vanyap1/SAMD20_EincSmartMonitor/images/pic2.png

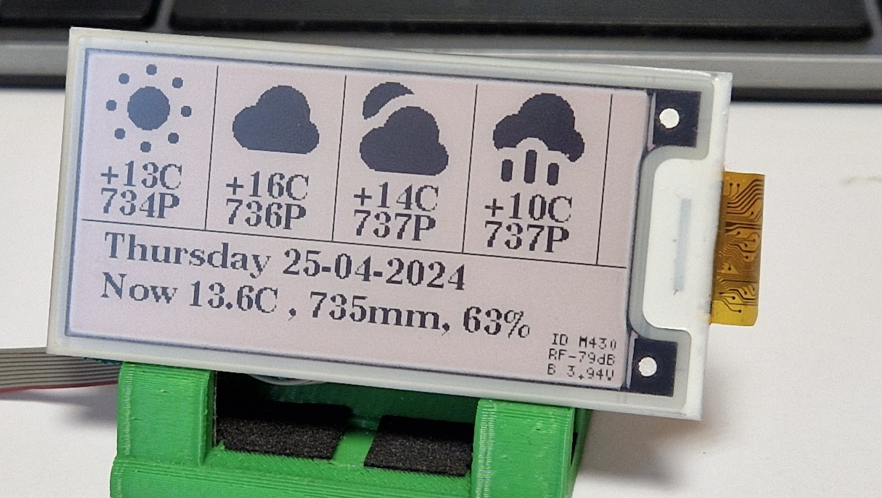
images/pic2.png
