vanyap1/SAMD20_EincSmartMonitor/images/pic1.png

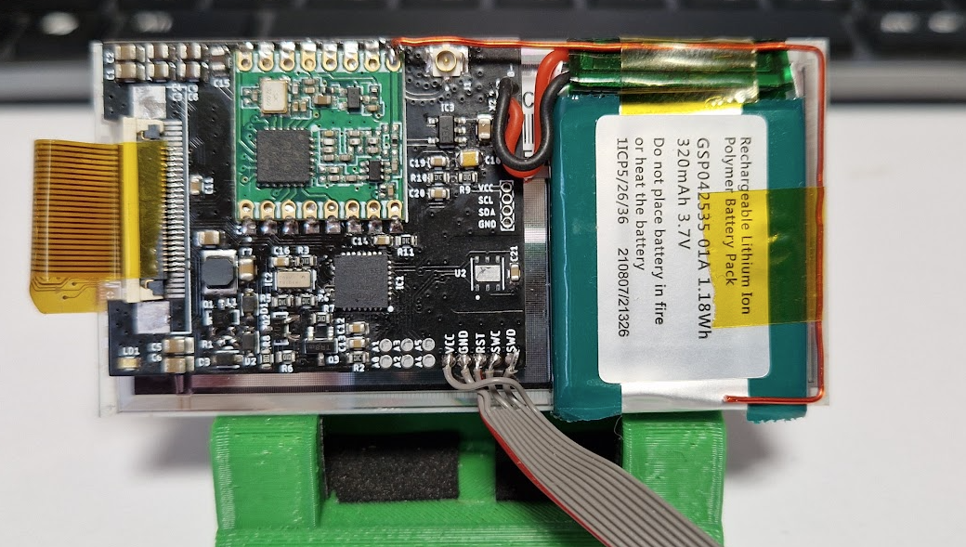
images/pic1.png
