vanyap1/SAMD20_EincSmartMonitor/README.md

# SAMD20_EinkSmartMonitor
Atmel SAMD20E17 mcu based EINK smart monitor with LORA module
