vanyap1/SAMD20_EincSmartMonitor/docu/u8g2_font_streamline_all_t.png

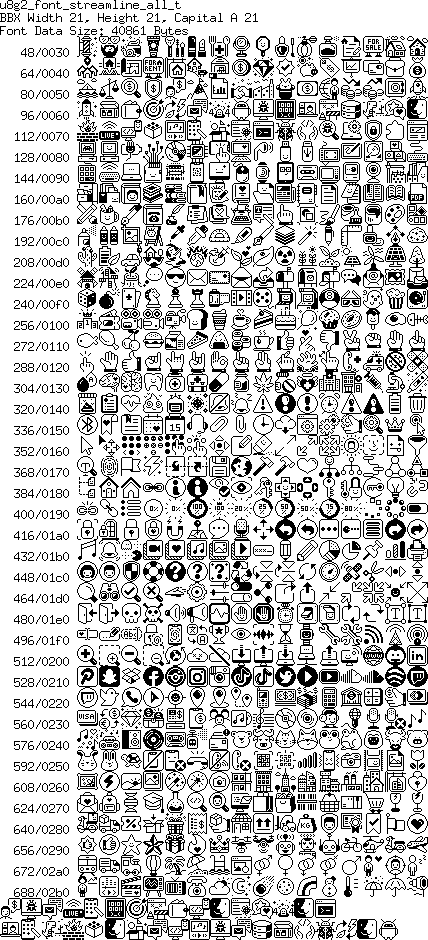
docu/u8g2_font_streamline_all_t.png
