vanyap1/SAMD20_EincSmartMonitor/images/pic3.png

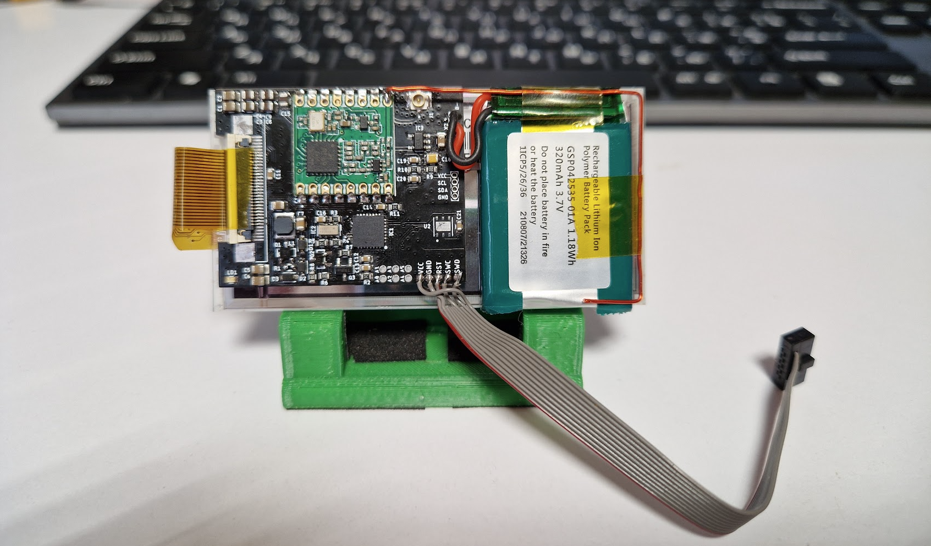
images/pic3.png
