vanyap1/SAMD20_EincSmartMonitor/images/pic4.png

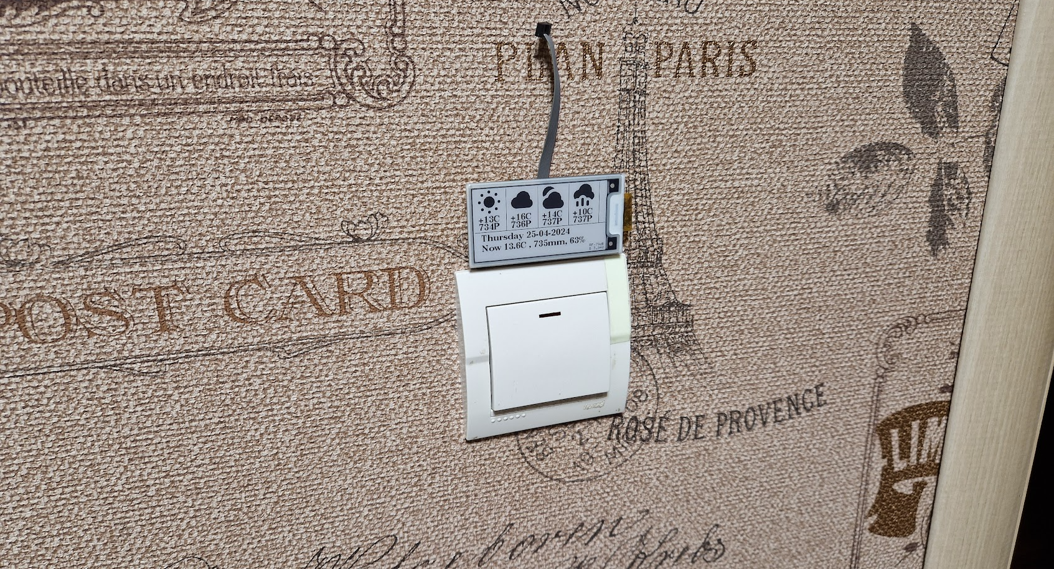
images/pic4.png
