vanyap1/SAMD20_EincSmartMonitor/3dParts/FrontCover_154.SLDPRT

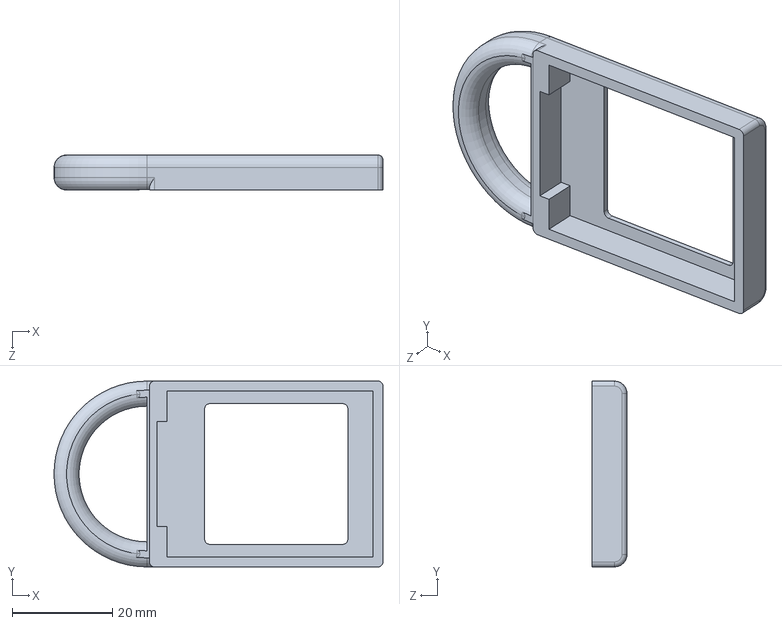
[picture p6: CAD file, 2024-04-30]
3dParts/FrontCover_154.SLDPRT
65.5 x 37.0 x 7.00 mm
