vanyap1/SAMD20_EincSmartMonitor/3dParts/FrontCover.SLDPRT

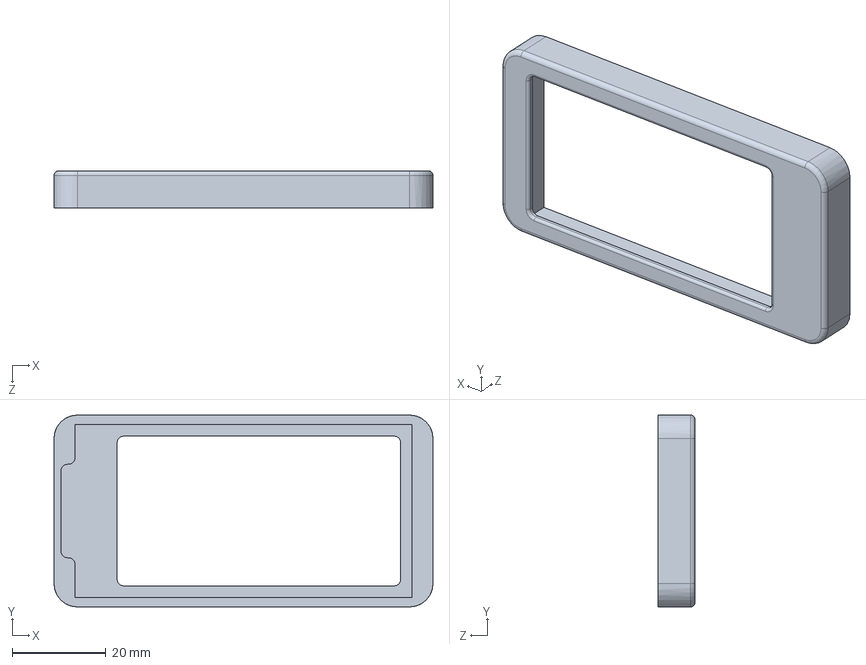
[picture p7: CAD file, 2024-04-27]
3dParts/FrontCover.SLDPRT
81.0 x 41.0 x 8.00 mm
