vanyap1/SAMD20_EincSmartMonitor/docu/eagle project/E-InkSmartMonitor.pdf

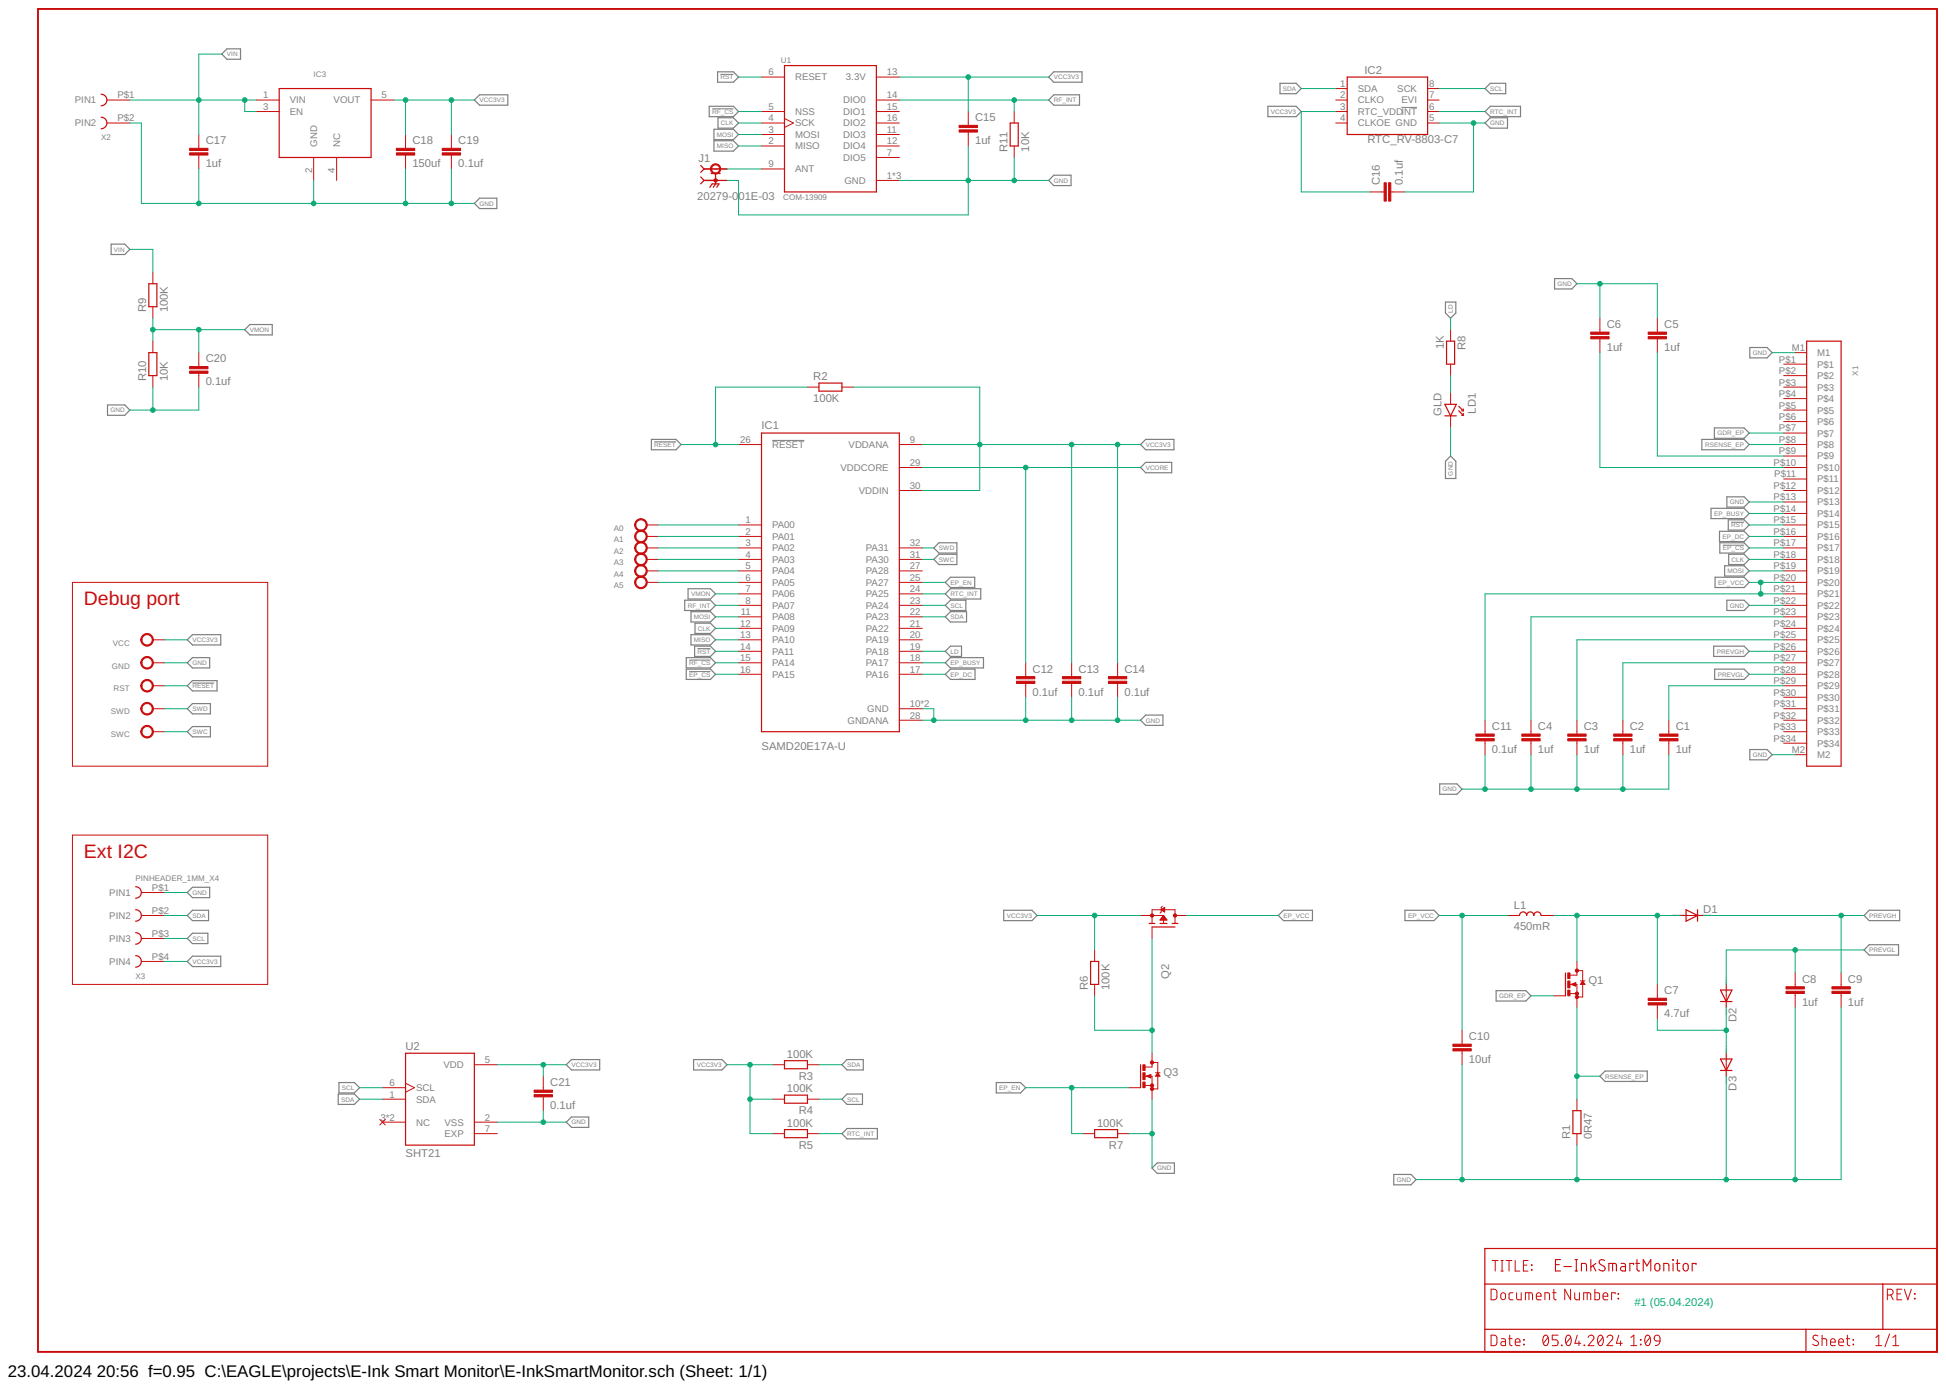
[picture p8: page 1]

SpiceOrder 1 SpiceOrder 2

23.04.2024 20:56 f=0.95 C:\EAGLE\projects\E-Ink Smart Monitor\E-InkSmartMonitor.sch (Sheet: 1/1)
