vanyap1/SAMD20_EincSmartMonitor/docu/eagle project/E-InkSmartMonitor.brd

## EAGLE design docu/eagle project/E-InkSmartMonitor.brd (2024-04-24)

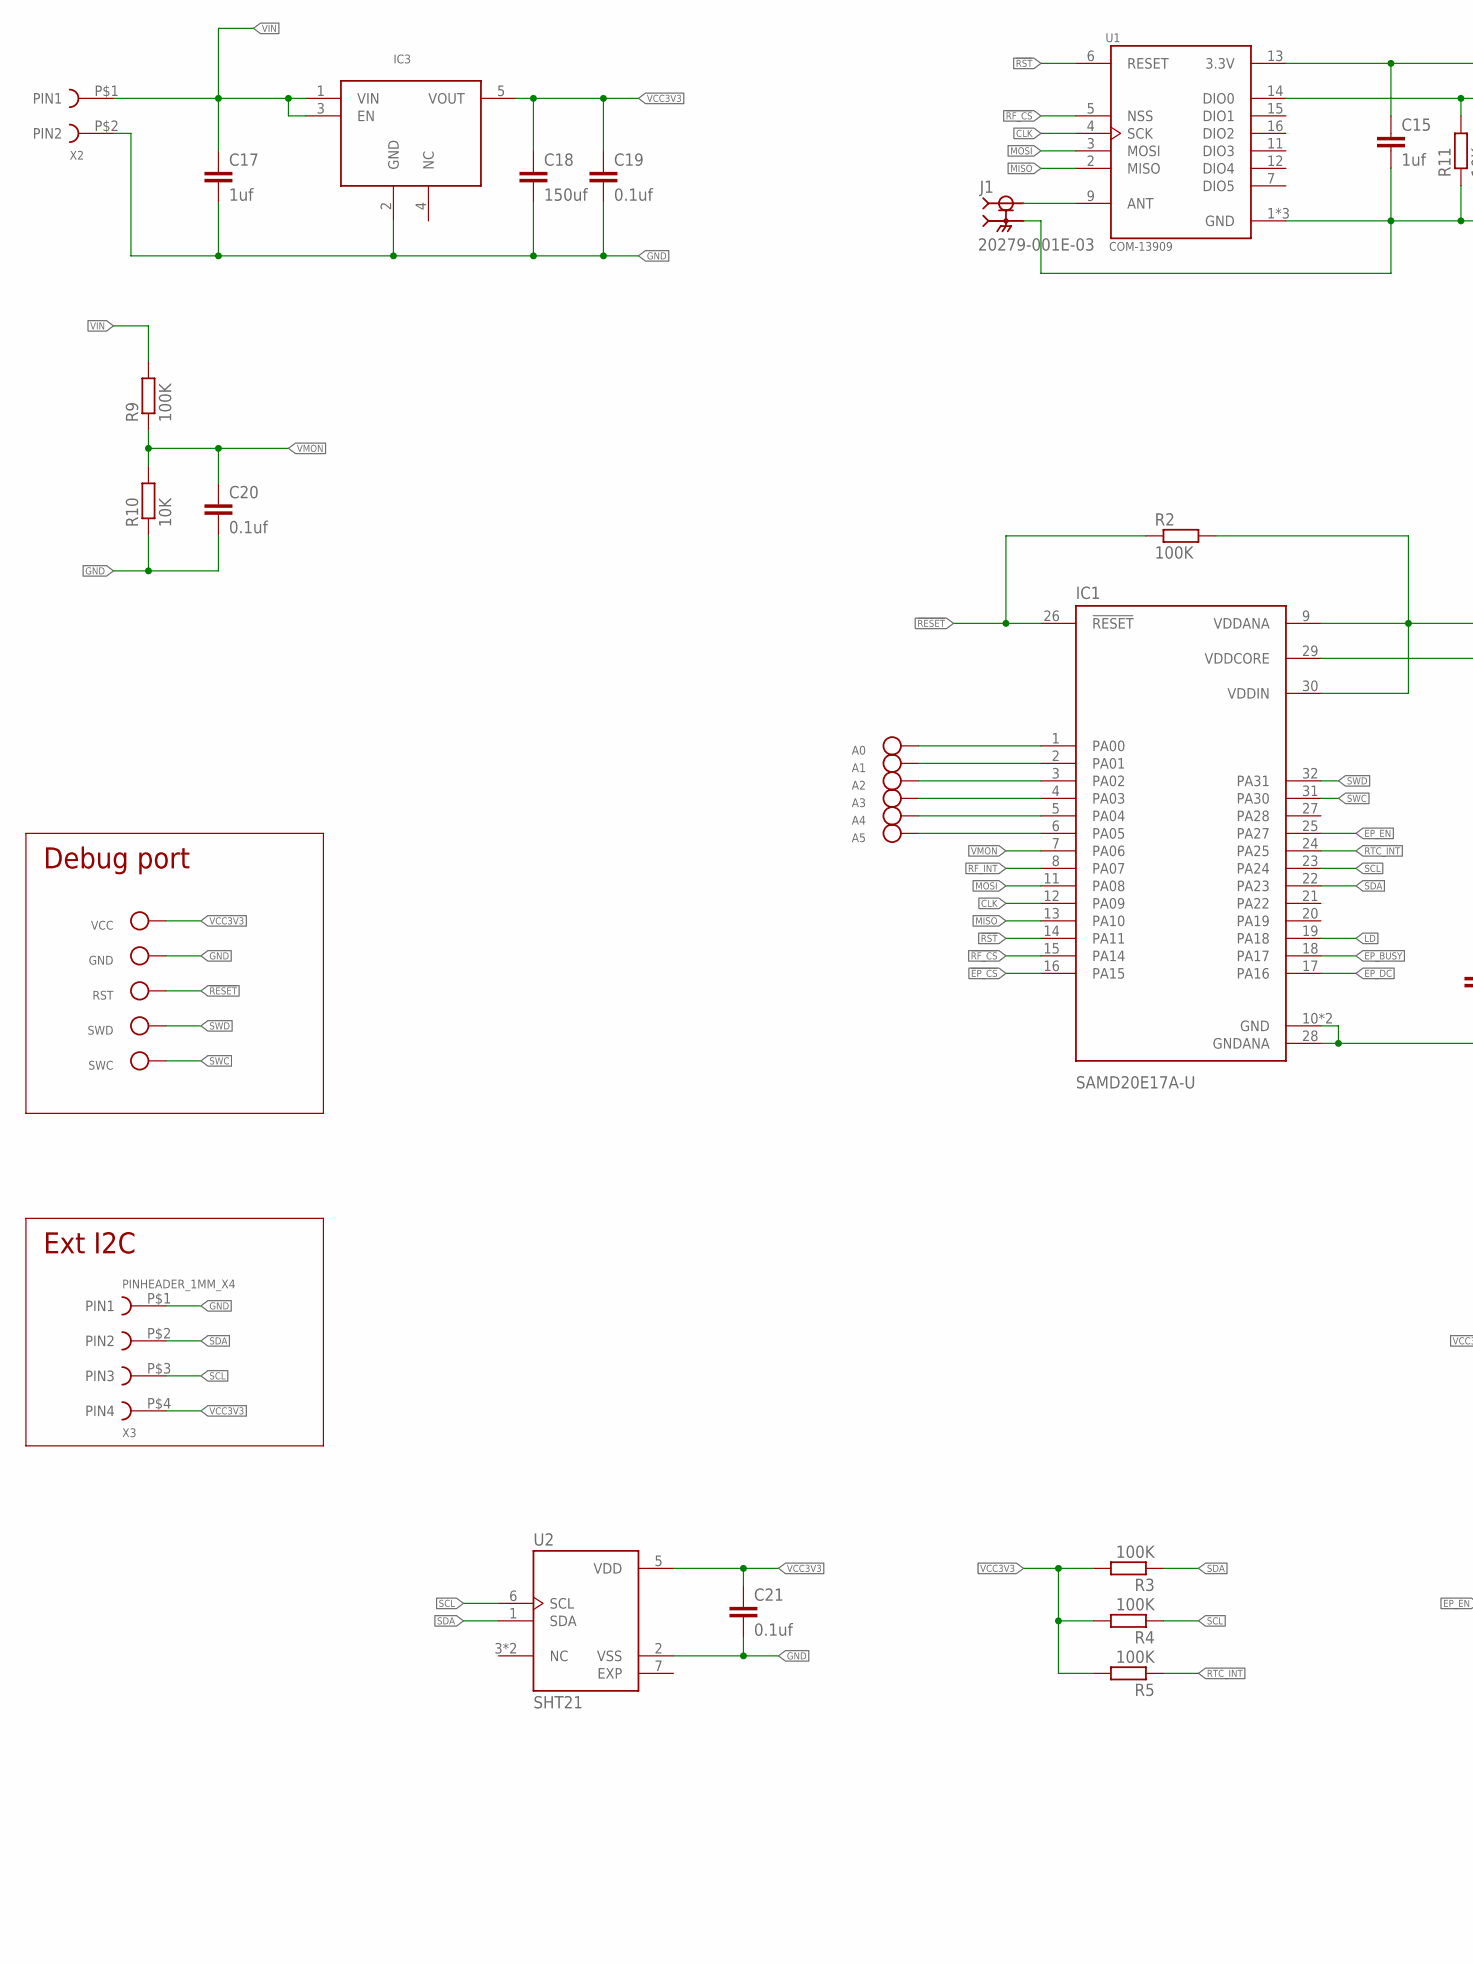
[picture p9: schematic E-InkSmartMonitor.sch, part in row 1, column 1]

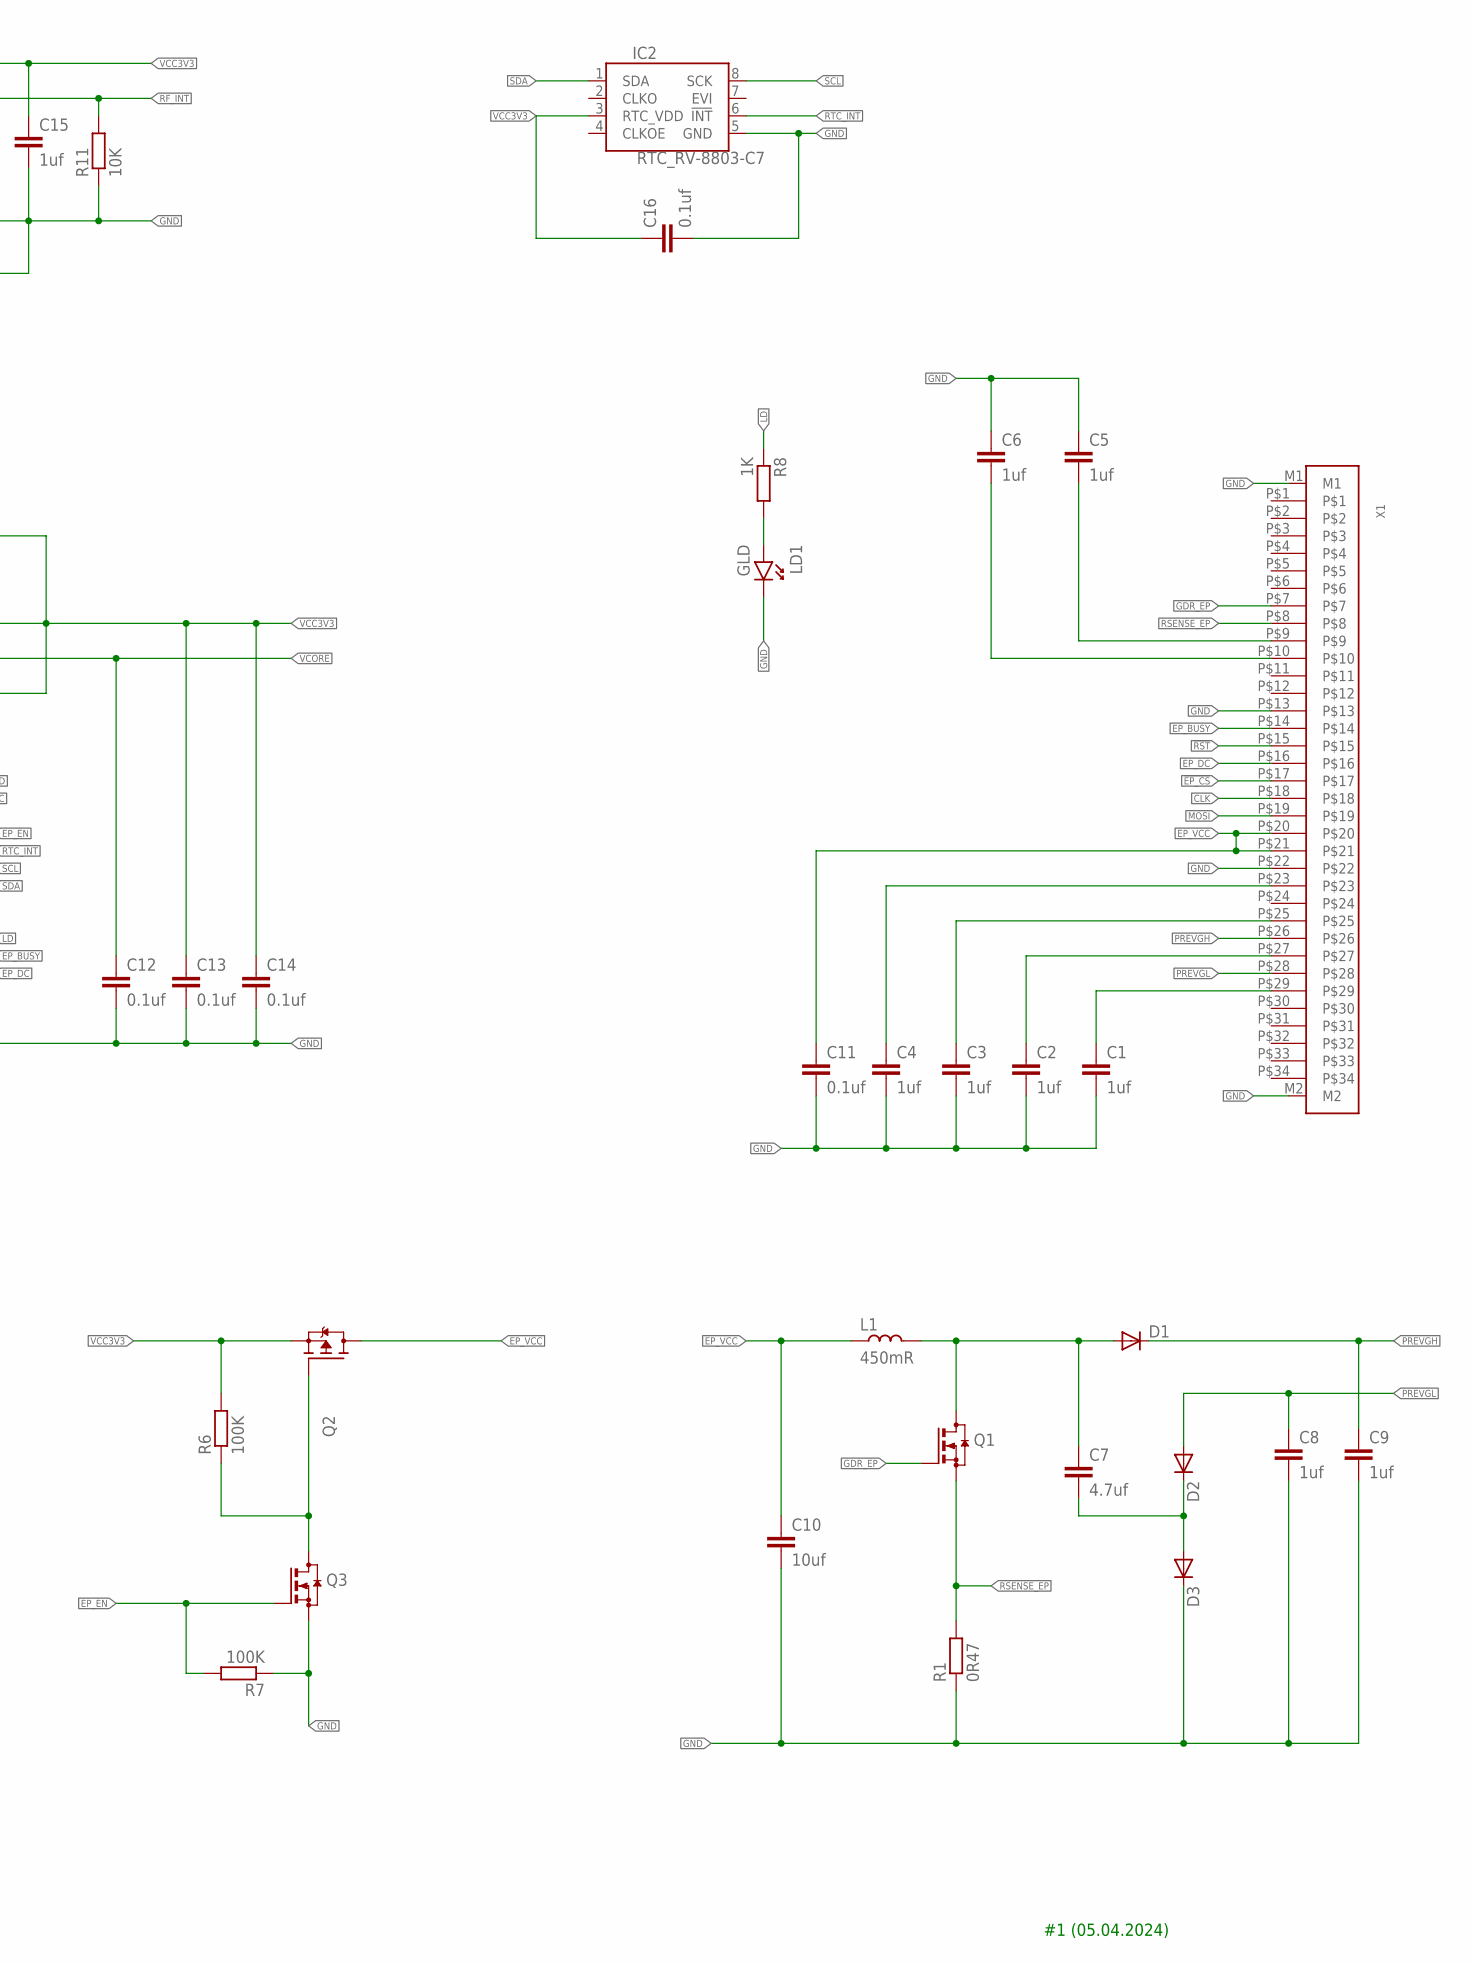
[picture p10: schematic E-InkSmartMonitor.sch, part in row 1, column 2]

Parts:
A0, A1, A2, A3, A4, A5: TEST_POINT_D2MM; TP
C1, C2, C3, C4, C5, C6, C8, C9, C15, C17: 1uf; 0805
C7: 4.7uf; 0805
C10: 10uf; 0805
C11, C12, C13, C14, C16, C19, C20, C21: 0.1uf; 0603
C18: 150uf; 0805
D1, D2, D3: DIODE-SOD323-R; SOD323-R
GND: TEST_POINT_D2MM; TP
IC1: SAMD20E17A-U; MLF32-TH
IC2: RTC_RV-8803-C7; C7_RTC
IC3: LDO_3.3V_SOT23(5); SOT-23(5)
J1: 20279-001E-03; IPEX_20279-001E-03
L1: 450mR; 3232
LD1: GLD; 0603_P
Q1, Q3: BSS123SOT-23-3; SOT-23(3)
Q2: P_CH_SOT23SOT-23-3; SOT-23(3)
R1: 0R47; 0603
R2, R3, R4, R5, R6, R7, R9: 100K; 0603
R8: 1K; 0603
R10, R11: 10K; 0603
RST: TEST_POINT_D2MM; TP
SWC: TEST_POINT_D2MM; TP
SWD: TEST_POINT_D2MM; TP
U1: COM-13909; MOD_COM-13909
U2: SHT21; XDCR_SHT21
VCC: TEST_POINT_D2MM; TP
X1: FFC_3405EINK
X2: PINHEADER_1MM_X22X_1MM_PIN; PIN_1MM_X2
X3: PINHEADER_1MM_X4; PIN_1MM_X4

Connections:
!EP_CS: IC1.16 (PA15), X1.P$17
!RESET: IC1.26 (!RESET), R2.1, RST.P$1
!RF_CS: IC1.15 (PA14), U1.5 (NSS)
CLK: IC1.12 (PA09), U1.4 (SCK), X1.P$18
EP_BUSY: IC1.18 (PA17), X1.P$14
EP_DC: IC1.17 (PA16), X1.P$16
EP_EN: IC1.25 (PA27), Q3.1 (G), R7.2
EP_VCC: C10.1, C11.1, L1.M (1), Q2.3 (D), X1.P$20, X1.P$21
GDR_EP: Q1.1 (G), X1.P$7
GND: C1.2, C2.2, C3.2, C4.2, C5.1, C6.1, C8.2, C9.2, C10.2, C11.2, C12.2, C13.2, C14.2, C15.2, C16.2, C17.2, C18.2, C19.2, C20.2, C21.2, D3.C, GND.P$1, IC1.10 (GND), IC1.28 (GNDANA), IC1.TH (GND), IC2.5 (GND), IC3.2 (GND), J1.2 (GND), J1.3 (GND), LD1.1 (K), Q3.2 (S), R1.1, R7.1, R10.1, R11.1, U1.1 (GND), U1.8 (GND), U1.10 (GND), U2.2 (VSS), X1.M1, X1.M2, X1.P$13, X1.P$22, X2.P$2 (PIN2), X3.P$1 (PIN1)
LD: IC1.19 (PA18), R8.1
MISO: IC1.13 (PA10), U1.2 (MISO)
MOSI: IC1.11 (PA08), U1.3 (MOSI), X1.P$19
unnamed: J1.1 (SIG), U1.9 (ANT)
unnamed: Q2.1 (G), Q3.3 (D), R6.1
unnamed: C5.2, X1.P$9
unnamed: C6.2, X1.P$10
unnamed: C7.1, D1.A, L1.P (2), Q1.3 (D)
unnamed: LD1.2 (A), R8.2
unnamed: C7.2, D2.C, D3.A
unnamed: C4.1, X1.P$23
unnamed: C3.1, X1.P$25
unnamed: C2.1, X1.P$27
unnamed: C1.1, X1.P$29
PA00: A0.P$1, IC1.1 (PA00)
PA01: A1.P$1, IC1.2 (PA01)
PA02: A2.P$1, IC1.3 (PA02)
PA03: A3.P$1, IC1.4 (PA03)
PA04: A4.P$1, IC1.5 (PA04)
PA05: A5.P$1, IC1.6 (PA05)
PREVGH: C9.1, D1.C, X1.P$26
PREVGL: C8.1, D2.A, X1.P$28
RF_INT: IC1.8 (PA07), R11.2, U1.14 (DIO0)
RSENSE_EP: Q1.2 (S), R1.2, X1.P$8
RTC_INT: IC1.24 (PA25), IC2.6 (!INT), R5.1
SCL: IC1.23 (PA24), IC2.8 (SCK), R4.1, U2.6 (SCL), X3.P$3 (PIN3)
SDA: IC1.22 (PA23), IC2.1 (SDA), R3.1, U2.1 (SDA), X3.P$2 (PIN2)
SWC: IC1.31 (PA30), SWC.P$1
SWD: IC1.32 (PA31), SWD.P$1
VCC3V3: C13.1, C14.1, C15.1, C16.1, C18.1, C19.1, C21.1, IC1.9 (VDDANA), IC1.30 (VDDIN), IC2.3 (RTC_VDD), IC3.5 (VOUT), Q2.2 (S), R2.2, R3.2, R4.2, R5.2, R6.2, U1.13 (3.3V), U2.5 (VDD), VCC.P$1, X3.P$4 (PIN4)
VCORE: C12.1, IC1.29 (VDDCORE)
VIN: C17.1, IC3.1 (VIN), IC3.3 (EN), R9.2, X2.P$1 (PIN1)
VMON: C20.1, IC1.7 (PA06), R9.1, R10.2

Notes on the sheet:
Debug port
Ext I2C
#1 (05.04.2024)

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
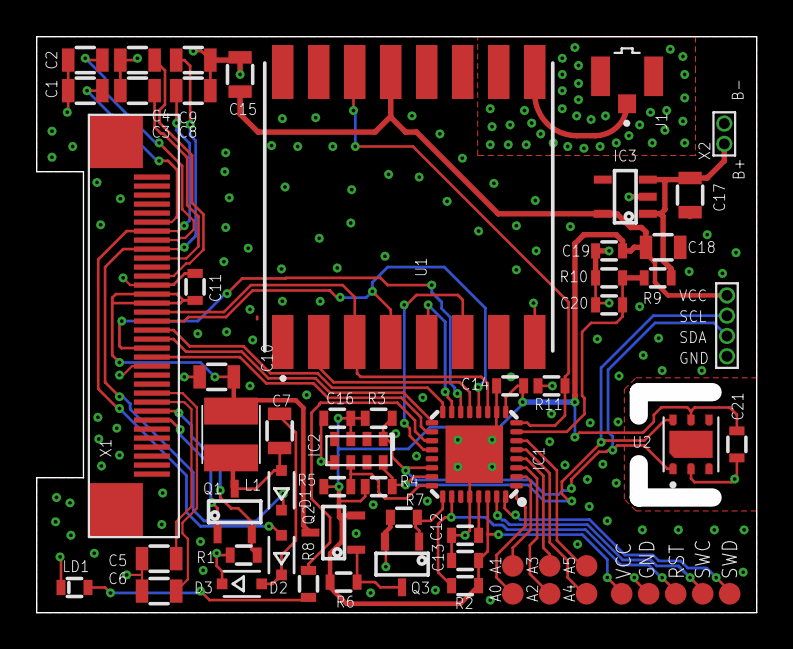
[picture p11: board E-InkSmartMonitor.brd from above]

Board: 2 copper layers, 40.0 x 32.0 mm, 60 parts (0 on the bottom side), 45 nets.
