vanyap1/SAMD20_EincSmartMonitor/EinkSamd20E17_MCU/EinkSamd20E17_MCU/driver_init.c

/*
 * Code generated from Atmel Start.
 *
 * This file will be overwritten when reconfiguring your Atmel Start project.
 * Please copy examples or other code you want to keep to a separate file
 * to avoid losing it when reconfiguring.
 */

#include "driver_init.h"
#include <peripheral_clk_config.h>
#include <utils.h>
#include <hal_init.h>
#include <hpl_gclk_base.h>
#include <hpl_pm_base.h>

#include <hpl_adc_base.h>

struct spi_m_sync_descriptor SPI_0;

struct adc_sync_descriptor ADC_0;

struct i2c_m_sync_desc I2C_0;

void ADC_0_PORT_init(void)
{

	// Disable digital pin circuitry
	gpio_set_pin_direction(PA06, GPIO_DIRECTION_OFF);

	gpio_set_pin_function(PA06, PINMUX_PA06B_ADC_AIN6);
}

void ADC_0_CLOCK_init(void)
{
	_pm_enable_bus_clock(PM_BUS_APBC, ADC);
	_gclk_enable_channel(ADC_GCLK_ID, CONF_GCLK_ADC_SRC);
}

void ADC_0_init(void)
{
	ADC_0_CLOCK_init();
	ADC_0_PORT_init();
	adc_sync_init(&ADC_0, ADC, (void *)NULL);
}

void EXTERNAL_IRQ_0_init(void)
{
	_gclk_enable_channel(EIC_GCLK_ID, CONF_GCLK_EIC_SRC);

	// Set pin direction to input
	gpio_set_pin_direction(RF_INT, GPIO_DIRECTION_IN);

	gpio_set_pin_pull_mode(RF_INT,
	                       // <y> Pull configuration
	                       // <id> pad_pull_config
	                       // <GPIO_PULL_OFF"> Off
	                       // <GPIO_PULL_UP"> Pull-up
	                       // <GPIO_PULL_DOWN"> Pull-down
	                       GPIO_PULL_OFF);

	gpio_set_pin_function(RF_INT, PINMUX_PA07A_EIC_EXTINT7);

	// Set pin direction to input
	gpio_set_pin_direction(RTC_INT, GPIO_DIRECTION_IN);

	gpio_set_pin_pull_mode(RTC_INT,
	                       // <y> Pull configuration
	                       // <id> pad_pull_config
	                       // <GPIO_PULL_OFF"> Off
	                       // <GPIO_PULL_UP"> Pull-up
	                       // <GPIO_PULL_DOWN"> Pull-down
	                       GPIO_PULL_OFF);

	gpio_set_pin_function(RTC_INT, PINMUX_PA25A_EIC_EXTINT13);

	ext_irq_init();
}

void SPI_0_PORT_init(void)
{

	gpio_set_pin_level(PA08,
	                   // <y> Initial level
	                   // <id> pad_initial_level
	                   // <false"> Low
	                   // <true"> High
	                   false);

	// Set pin direction to output
	gpio_set_pin_direction(PA08, GPIO_DIRECTION_OUT);

	gpio_set_pin_function(PA08, PINMUX_PA08C_SERCOM0_PAD0);

	gpio_set_pin_level(PA09,
	                   // <y> Initial level
	                   // <id> pad_initial_level
	                   // <false"> Low
	                   // <true"> High
	                   false);

	// Set pin direction to output
	gpio_set_pin_direction(PA09, GPIO_DIRECTION_OUT);

	gpio_set_pin_function(PA09, PINMUX_PA09C_SERCOM0_PAD1);

	// Set pin direction to input
	gpio_set_pin_direction(PA10, GPIO_DIRECTION_IN);

	gpio_set_pin_pull_mode(PA10,
	                       // <y> Pull configuration
	                       // <id> pad_pull_config
	                       // <GPIO_PULL_OFF"> Off
	                       // <GPIO_PULL_UP"> Pull-up
	                       // <GPIO_PULL_DOWN"> Pull-down
	                       GPIO_PULL_OFF);

	gpio_set_pin_function(PA10, PINMUX_PA10C_SERCOM0_PAD2);
}

void SPI_0_CLOCK_init(void)
{
	_pm_enable_bus_clock(PM_BUS_APBC, SERCOM0);
	_gclk_enable_channel(SERCOM0_GCLK_ID_CORE, CONF_GCLK_SERCOM0_CORE_SRC);
}

void SPI_0_init(void)
{
	SPI_0_CLOCK_init();
	spi_m_sync_init(&SPI_0, SERCOM0);
	SPI_0_PORT_init();
}

void I2C_0_PORT_init(void)
{

	gpio_set_pin_pull_mode(PA22,
	                       // <y> Pull configuration
	                       // <id> pad_pull_config
	                       // <GPIO_PULL_OFF"> Off
	                       // <GPIO_PULL_UP"> Pull-up
	                       // <GPIO_PULL_DOWN"> Pull-down
	                       GPIO_PULL_OFF);

	gpio_set_pin_function(PA22, PINMUX_PA22C_SERCOM3_PAD0);

	gpio_set_pin_pull_mode(PA23,
	                       // <y> Pull configuration
	                       // <id> pad_pull_config
	                       // <GPIO_PULL_OFF"> Off
	                       // <GPIO_PULL_UP"> Pull-up
	                       // <GPIO_PULL_DOWN"> Pull-down
	                       GPIO_PULL_OFF);

	gpio_set_pin_function(PA23, PINMUX_PA23C_SERCOM3_PAD1);
}

void I2C_0_CLOCK_init(void)
{
	_pm_enable_bus_clock(PM_BUS_APBC, SERCOM3);
	_gclk_enable_channel(SERCOM3_GCLK_ID_CORE, CONF_GCLK_SERCOM3_CORE_SRC);
	_gclk_enable_channel(SERCOM3_GCLK_ID_SLOW, CONF_GCLK_SERCOM3_SLOW_SRC);
}

void I2C_0_init(void)
{
	I2C_0_CLOCK_init();
	i2c_m_sync_init(&I2C_0, SERCOM3);
	I2C_0_PORT_init();
}

void delay_driver_init(void)
{
	delay_init(SysTick);
}

void system_init(void)
{
	init_mcu();

	// GPIO on PA14

	gpio_set_pin_level(RF_CS,
	                   // <y> Initial level
	                   // <id> pad_initial_level
	                   // <false"> Low
	                   // <true"> High
	                   true);

	// Set pin direction to output
	gpio_set_pin_direction(RF_CS, GPIO_DIRECTION_OUT);

	gpio_set_pin_function(RF_CS, GPIO_PIN_FUNCTION_OFF);

	// GPIO on PA15

	gpio_set_pin_level(EP_CS,
	                   // <y> Initial level
	                   // <id> pad_initial_level
	                   // <false"> Low
	                   // <true"> High
	                   true);

	// Set pin direction to output
	gpio_set_pin_direction(EP_CS, GPIO_DIRECTION_OUT);

	gpio_set_pin_function(EP_CS, GPIO_PIN_FUNCTION_OFF);

	// GPIO on PA16

	gpio_set_pin_level(EP_CMD,
	                   // <y> Initial level
	                   // <id> pad_initial_level
	                   // <false"> Low
	                   // <true"> High
	                   true);

	// Set pin direction to output
	gpio_set_pin_direction(EP_CMD, GPIO_DIRECTION_OUT);

	gpio_set_pin_function(EP_CMD, GPIO_PIN_FUNCTION_OFF);

	// GPIO on PA17

	// Set pin direction to input
	gpio_set_pin_direction(EP_BUSY, GPIO_DIRECTION_IN);

	gpio_set_pin_pull_mode(EP_BUSY,
	                       // <y> Pull configuration
	                       // <id> pad_pull_config
	                       // <GPIO_PULL_OFF"> Off
	                       // <GPIO_PULL_UP"> Pull-up
	                       // <GPIO_PULL_DOWN"> Pull-down
	                       GPIO_PULL_UP);

	gpio_set_pin_function(EP_BUSY, GPIO_PIN_FUNCTION_OFF);

	// GPIO on PA18

	gpio_set_pin_level(GLD,
	                   // <y> Initial level
	                   // <id> pad_initial_level
	                   // <false"> Low
	                   // <true"> High
	                   false);

	// Set pin direction to output
	gpio_set_pin_direction(GLD, GPIO_DIRECTION_OUT);

	gpio_set_pin_function(GLD, GPIO_PIN_FUNCTION_OFF);

	// GPIO on PA27

	gpio_set_pin_level(EP_EN,
	                   // <y> Initial level
	                   // <id> pad_initial_level
	                   // <false"> Low
	                   // <true"> High
	                   true);

	// Set pin direction to output
	gpio_set_pin_direction(EP_EN, GPIO_DIRECTION_OUT);

	gpio_set_pin_function(EP_EN, GPIO_PIN_FUNCTION_OFF);

	ADC_0_init();
	EXTERNAL_IRQ_0_init();

	SPI_0_init();

	I2C_0_init();

	delay_driver_init();
}
