vanyap1/SAMD20_EincSmartMonitor/EinkSamd20E17_MCU/EinkSamd20E17_MCU/examples/driver_examples.c

/*
 * Code generated from Atmel Start.
 *
 * This file will be overwritten when reconfiguring your Atmel Start project.
 * Please copy examples or other code you want to keep to a separate file
 * to avoid losing it when reconfiguring.
 */

#include "driver_examples.h"
#include "driver_init.h"
#include "utils.h"

/**
 * Example of using ADC_0 to generate waveform.
 */
void ADC_0_example(void)
{
	uint8_t buffer[2];

	adc_sync_enable_channel(&ADC_0, 0);

	while (1) {
		adc_sync_read_channel(&ADC_0, 0, buffer, 2);
	}
}

static void button_on_PA07_pressed(void)
{
}

static void button_on_PA25_pressed(void)
{
}

/**
 * Example of using EXTERNAL_IRQ_0
 */
void EXTERNAL_IRQ_0_example(void)
{

	ext_irq_register(PIN_PA07, button_on_PA07_pressed);
	ext_irq_register(PIN_PA25, button_on_PA25_pressed);
}

/**
 * Example of using SPI_0 to write "Hello World" using the IO abstraction.
 */
static uint8_t example_SPI_0[12] = "Hello World!";

void SPI_0_example(void)
{
	struct io_descriptor *io;
	spi_m_sync_get_io_descriptor(&SPI_0, &io);

	spi_m_sync_enable(&SPI_0);
	io_write(io, example_SPI_0, 12);
}

void I2C_0_example(void)
{
	struct io_descriptor *I2C_0_io;

	i2c_m_sync_get_io_descriptor(&I2C_0, &I2C_0_io);
	i2c_m_sync_enable(&I2C_0);
	i2c_m_sync_set_slaveaddr(&I2C_0, 0x12, I2C_M_SEVEN);
	io_write(I2C_0_io, (uint8_t *)"Hello World!", 12);
}

void delay_example(void)
{
	delay_ms(5000);
}
