vanyap1/SAMD20_EincSmartMonitor/(commit log)

2024-04-24 project init
    [E-InkSmartMonitor.brd, E-InkSmartMonitor.sch]
2024-04-27 added real data drawing
    [FrontCover.SLDPRT]
2024-04-30 added 3d model for 1.54 inch screen
    [FrontCover_154.SLDPRT]
